PriBoris/MBLv1/Hardware/MBLv1 hardware utils.xlsx

Sheet: Sheet1
I nom | 0.35 | A
Intensity | 100 | %
I | 0.35 | A
R shunt | 0.100 | Ohm
U shunt | 0.035 | V
P shunt | 0.01225 | W
U offset | 0.006 | V
Amplifier
R1 | 220 | kOhm
R2 | 4.7 | kOhm
Gain | 47.80851064
U | 1.960148936

Sheet: BATTERY CHARGE
R shunt | 0.01 | ohm
I charge @5V | 1.5 | A
U | 4 | V
I charge | 1.875 | A
U shunt | 0.01875
P shunt | 0.03515625 | W
R load INA138 | 470000 | ohm
U load INA138 | 1.7625 | V

Sheet: USB VOLTAGE MONITORING
 |  |  | V USB
V REF INT | 1.224 | V | 3.918024
3/4 V REF INT | 0.918 | V | 2.938518
1/2 V REF INT | 0.612 | V | 1.959012
1/4 V REF INT | 0.306 | V | 0.979506
V USB MIN | 4.5 | V
Rup | 220 | kOhm
Rdown1 | 100 | kOhm
Rdown2 | 220000
Rdown | 99.95456611 | kOhm
G | 0.3124023743
V COMP IN | 1.405810684

Sheet: THERMAL
COPPER | 401 | W/m/K
TRACK
width | 1 | mm | 0.001 | m
length | 1 | mm | 0.001 | m
copper thickness | 0.1 | mm | 0.0001 | m
Area | 0.1 | mm^2 | 1e-07 | m^2
Theta |  |  | 24.938 | K/W
VIA
inner diameter | 0.5 | mm | 0.0005 | m
outer diameter | 0.6 | mm | 0.0006 | m
area | 0.082500 | mm^2 | 8.25e-08 | m^2
pcb thickness | 1.5 | mm | 0.0015 | m
Theta |  |  | 45.34119247 | K/W

Sheet: BATTERY OUT
string current | 0.35 | A
string voltage | 6.6 | V
string power | 2.31 | W
string count | 4
total LED power | 9.24
battery voltage | 3.5 | V
battery LED current | 2.64 | A
battery switch R | 0.01 | 0.05 | 0.1 | Ohm
battery switch P | 0.069696 | 0.34848 | 0.69696 | W
battery switch U | 0.0264 | 0.0264 | 0.0264 | V
