PriBoris/MBLv1/Hardware/BOM/MBLv1(both).xlsx

Comment | Quantity | Описание
CC1206KKX7R6BB226 | 9 | Конденсатор SMD 1206
CC0603KRX7R7BB224 | 4 | Конденсатор SMD 0603
CC0603KRX7R7BB104 | 12 | Конденсатор SMD 0603
LMV324IDR | 1 | Микросхема SO14
TPS71533DCKR | 1 | Микросхема SOT323-5
TPS28225D | 1 | Микросхема SO8
STM32L052C8T | 1 | Микросхема LQFP48
IHLP4040DZER101M | 5 | Индуктивность SMD 2525
CRA2512-FZ-R100ELF | 4 | Резистор SMD 2512
RC0603FR-074K7 | 7 | Резистор SMD 0603
RC0603FR-07100R | 2 | Резистор SMD 0603
RC0603FR-07220K | 8 | Резистор SMD 0603
RC0603FR-07470K | 5 | Резистор SMD 0603
RC0603FR-07100K | 6 | Резистор SMD 0603
CRA2512-FZ-R010ELF | 1 | Резистор SMD 2512
RC0603FR-0747K | 4 | Резистор SMD 0603
RC0603FR-075R1 | 4 | Резистор SMD 0603
TC-3121 | 3 | Кнопка
INA138NA | 1 | Микросхема SOT23-5
L-119EGWT | 1 | Светодиод красный/зеленый
10BQ040 | 4 | Диод SMB
30BQ040 | 1 | Диод SMC
BAT54 | 6 | Диод SOT23
IRLL2705 | 6 | Транзистор SOT223
IRF7410 | 1 | Транзистор SO8
IRLML6402 | 4 | Транзистор SOT23
IRLML2402 | 4 | Транзистор SOT23
PDTA143ET | 2 | Транзистор SOT23
MOLEX 47346-0001 | 1 | Разъем USB micro
LM75A | 2 | Микросхема SO8
RC1206JR-070R | 16 | Резистор SMD 1206
OLP-5065F6L-06A | 8 | Светодиод SMD
