PriBoris/MBLv1/Hardware/BOM/MBLv1(LEDBoard).xlsx

Comment | Quantity | Описание
CC0603KRX7R7BB104 | 1 | Конденсатор SMD 0603
LM75A | 1 | Микросхема SO8
RC1206JR-070R | 8 | Резистор SMD 1206
OLP-5065F6L-06A | 4 | Светодиод SMD
