PriBoris/MBLv1/Hardware/MBLv1(LEDBoard).step

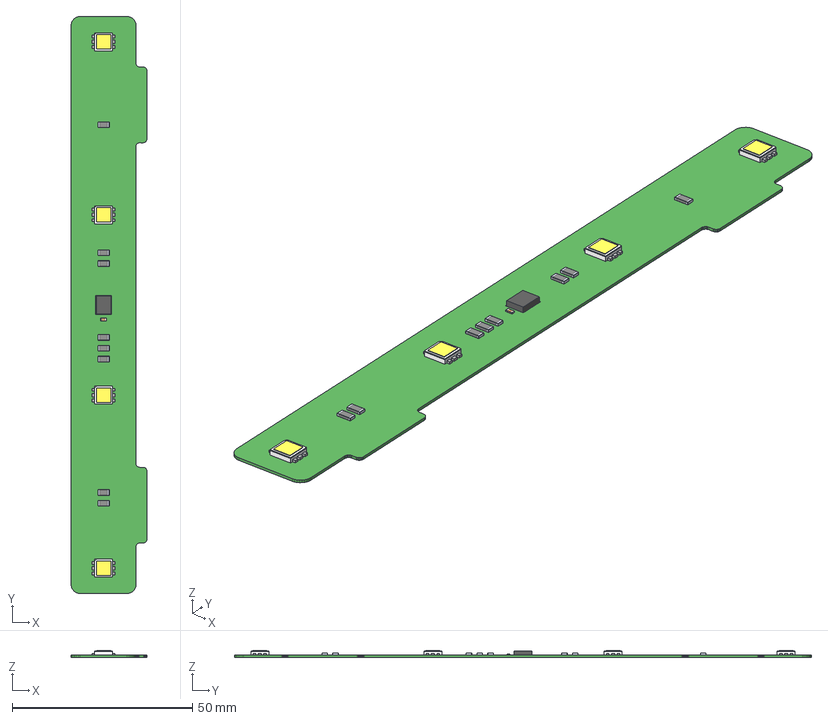
[picture p1: CAD file, 2017-07-03]
Hardware/MBLv1(LEDBoard).step
21.0 x 160.0 x 1.95 mm
Board
User_Library-Chip_Resistor2RESC3216X60N x 8
Extruded x 37
SW3dPS-0603_SMD_Capacitor
