PriBoris/MBLv1/Hardware/MBLv1.step

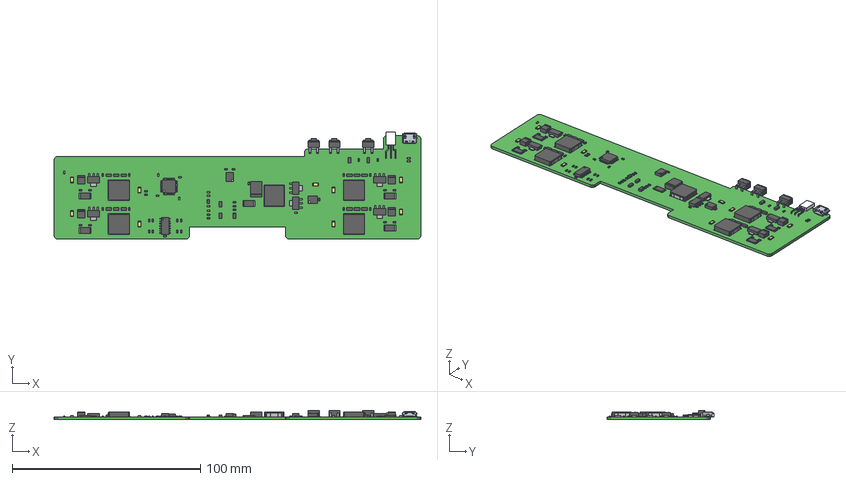
[picture p2: CAD file, 2017-06-19]
Hardware/MBLv1.step
195.0 x 57.0 x 5.03 mm
Board
Extruded x 380
