PriBoris/MBLv1/Hardware/MBLv1(LEDBoard).PDF

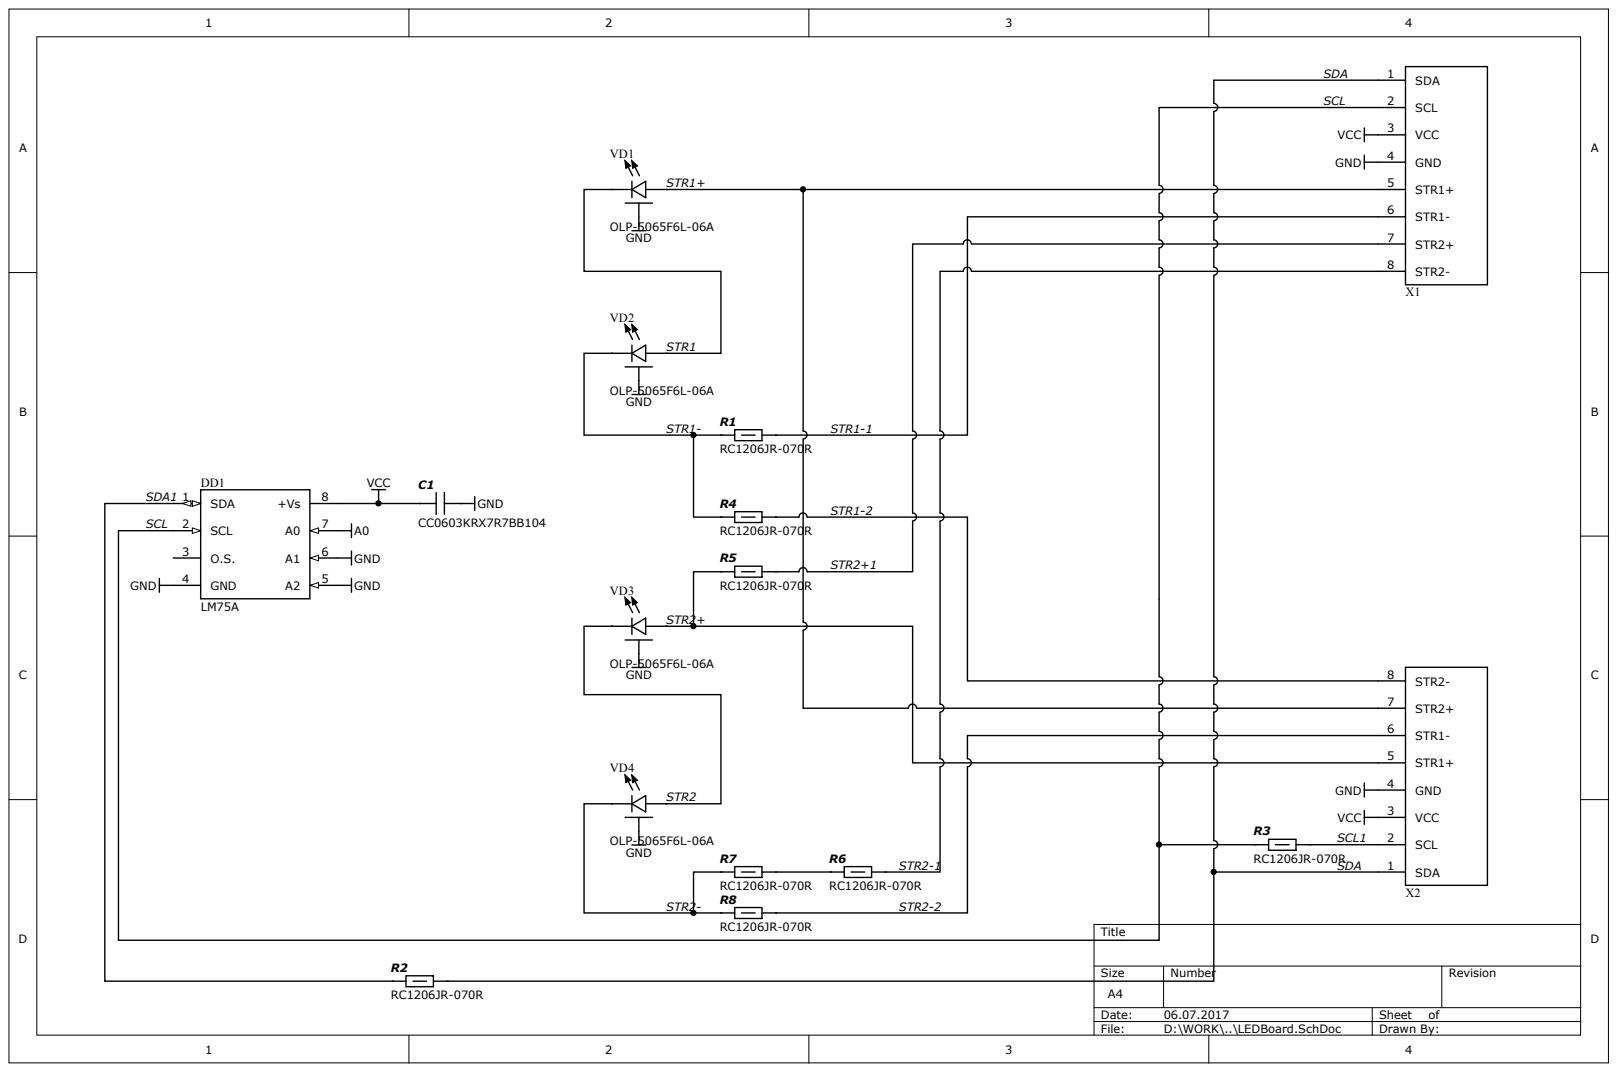
[picture p3: page 1]

SCL | 2

SCL 2

3 | SC L A0 A1 O.S. A2 | 5 GND | RC 1 2 0 6JR-0 7 0 R 5 | R STR2+1

OLP-5 | | F 6L-0 6 A

OLP-5
GND | R 7 | R 6 | STR2-1 | RC 1 2 0 6JR-0 7 0 R SDA 1

- | RC 6JR-0 R 8 | 7 0 R RC 6JR-0 7 0 R STR2-2

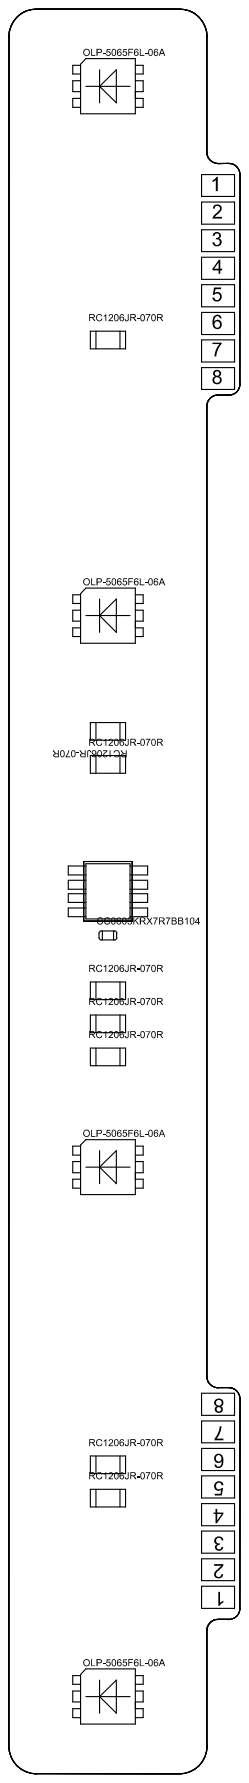
[picture p4: page 2]

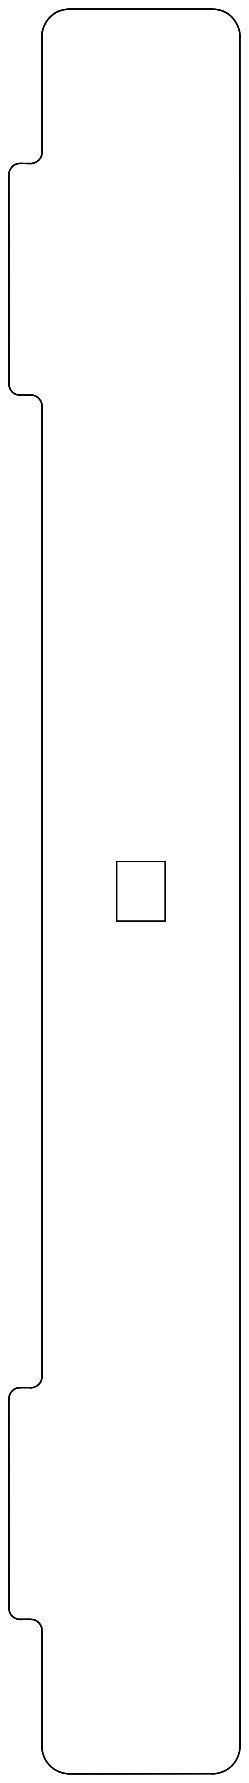
[picture p5: page 3]

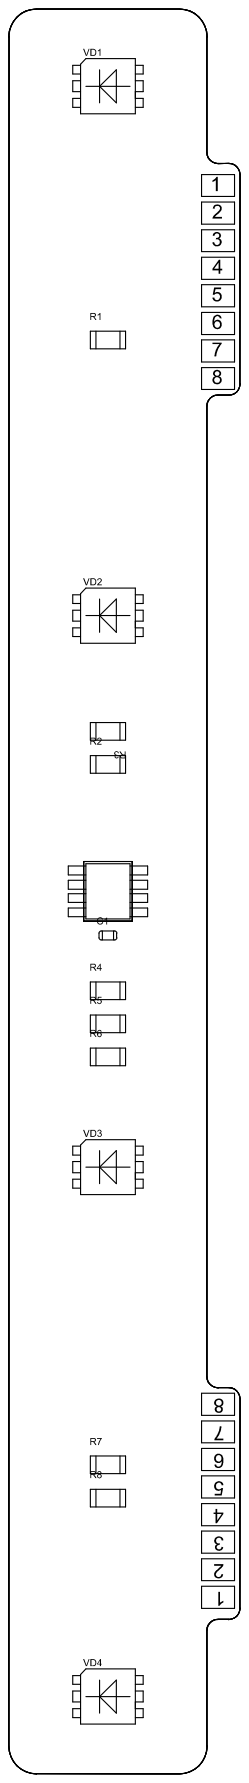
[picture p6: page 4]

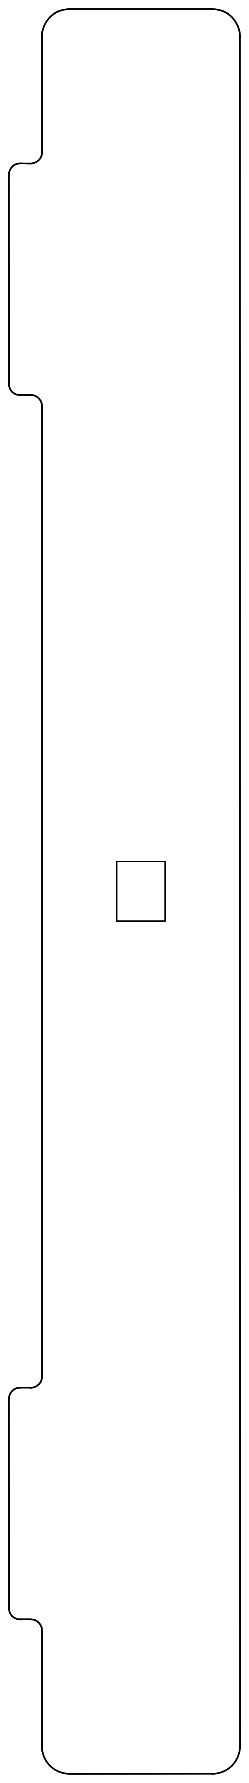
[picture p7: page 5]

Comment | Designator | Quantity | Описание

CC0603KRX7R7BB104 | C1 | 1 | Конденсатор SMD 0603
LM75A | DD1 | 1 | Микросхема SO8
RC1206JR-070R | R1, R2, R3, R4, R5, R6, R7, R8 | 8 | Резистор SMD 1206

OLP-5065F6L-06A | VD1, VD2, VD3, VD4 | 4 | Светодиод SMD

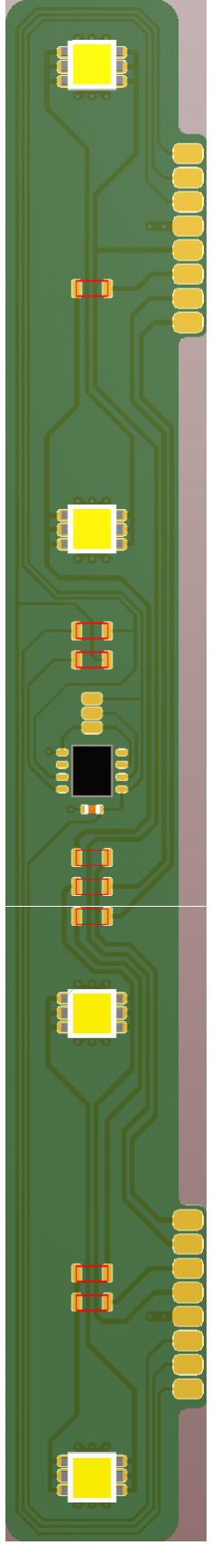
[picture p8: figure]

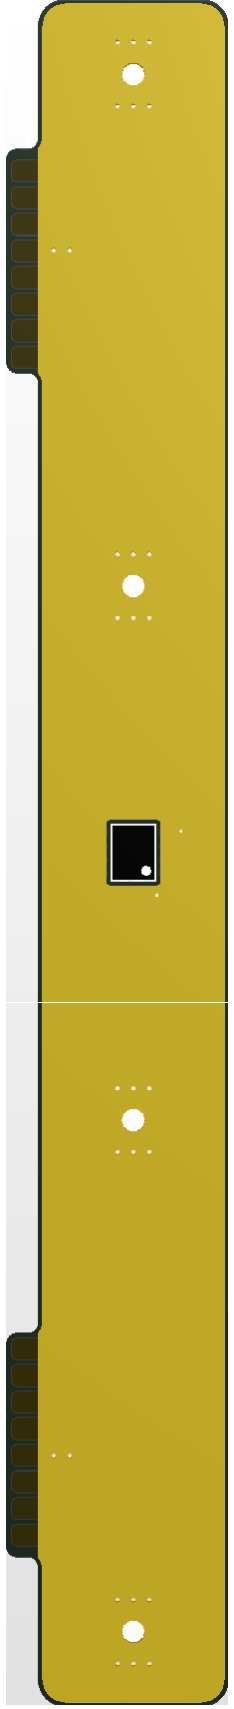
[picture p9: figure]
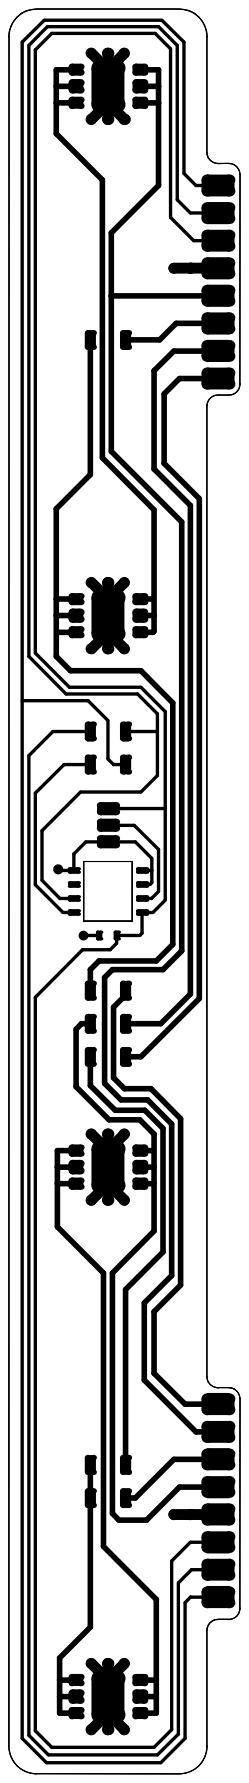
[picture p10: page 9]

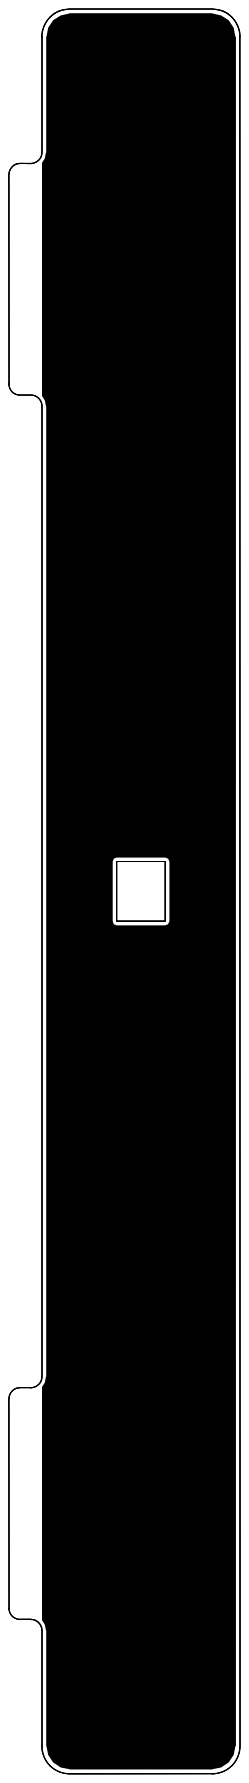
[picture p11: page 10]
