PriBoris/MBLv1/Hardware/Simulation/charger1.CIR

[Main]
FileType=CIR
Version=9.00
Program=Micro-Cap
Screen=1920,1080
MCAPVersion=9.0.7.0
Key ID=2 233 293 684
NLCnt=66
TXCnt=6

[shapedef]
Name=Battery
Line=0,0,22,0
Line=22,-3,22,3
Line=26,-7,26,7
Line=26,0,48,0
Current=32,8,16,8

[shapedef]
Name=SPICE_V
Root="Vsource.root",0,-12,0

[shapedef]
Name=Resistor
PolyOpen=12 
PolyLine=0,0
PolyLine=0,0
PolyLine=12,0
PolyLine=14,-4
PolyLine=18,4
PolyLine=22,-4
PolyLine=26,4
PolyLine=30,-4
PolyLine=34,4
PolyLine=36,0
PolyLine=48,0
PolyLine=48,0
Current=32,8,16,8

[shapedef]
Name=Capacitor
Line=0,0,22,0
Line=22,-8,22,8
Line=26,-8,26,8
Line=26,0,48,0
Current=32,12,16,12

[shapedef]
Name=Inductor
Line=42,0,48,0
Line=0,0,5,0
Arc=5,-7,17,7 , 11,-7,5,0
Arc=13,-7,25,7 , 19,-7,13,0
Arc=29,-7,41,7 , 35,-7,29,0
Arc=21,-7,33,7 , 27,-7,21,0
Arc=6,-7,18,7 , 18,0,12,-7
Arc=14,-7,26,7 , 26,0,20,-7
Arc=22,-7,34,7 , 34,0,28,-7
Arc=30,-7,42,7 , 42,0,36,-7
Line=11,-7,12,-7
Line=19,-7,20,-7
Line=27,-7,28,-7
Line=35,-7,36,-7
Arc=13,-4,17,2 , 13,-1,15,2
Arc=29,-4,33,2 , 29,-1,31,2
Arc=21,-4,25,2 , 21,-1,23,2
Arc=14,-4,18,2 , 16,2,18,-1
Arc=30,-4,34,2 , 32,2,34,-1
Arc=22,-4,26,2 , 24,2,26,-1
Line=15,2,16,2
Line=23,2,24,2
Line=31,2,32,2
Line=5,5,9,5
Line=41,5,41,9
Line=39,7,43,7
Current=32,8,16,8

[shapedef]
Name=Schottky
Arc=18,-13,31,1 , 27,-13,18,-7
Root="Diode.root",0,-8,0
Arc=19,-13,30,0 , 27,-13,19,-7
Arc=8,0,20,13 , 12,13,20,7
Arc=9,0,19,13 , 12,13,19,7

[shapedef]
Name=DNMOS
Root="Mos2.root",0,-24,0
Line=14,0,24,0
PolyClosed=3 ,Solid
PolyLine=17,0
PolyLine=20,-3
PolyLine=20,3

[shapedef]
Name=DPMOS
Root="Mos2.root",0,-24,0
Line=14,0,24,0
PolyClosed=3 ,Solid
PolyLine=17,-3
PolyLine=17,3
PolyLine=20,0

[shapedef]
Name=Ground
Line=0,0,12,0
Line=12,-8,12,8
Line=18,-4,18,4
Line=24,0,24,0

[shapedef]
Name=Diode.root
Line=0,0,20,0
Line=28,0,48,0
Rectangle=18,-8,20,8,SOLID
PolyClosed=3 ,Solid
PolyLine=20,0
PolyLine=28,-8
PolyLine=28,8
Current=32,16,16,16

[shapedef]
Name=Vsource.root
Line=0,0,12,0
Line=36,0,48,0
Ellipse=12,-12,36,12
Line=7,5,7,9
Root="Plus.root",39,5,0
Current=32,16,16,16

[shapedef]
Name=Plus.root
Line=-2,0,2,0
Line=0,-2,0,2

[shapedef]
Name=Mos2.root
Line=0,8,10,8
Line=10,-8,10,8
Line=14,-11,14,-5
Line=14,-3,14,3
Line=14,5,14,11
Line=14,-8,24,-8
Line=14,8,24,8
Line=24,0,24,24
Line=24,-8,24,-24
Current=32,-24,32,-16
Current=32,24,32,16
Current=0,0,8,0

[compdef]
Name=IRLL2705_IR
Definition=Subckt
Shape=DNMOS
Mask=4224
memo=N-Channel HEXFET Power MOSFET 55V 3.8A
Label Offset=30,-13,-6,26
PinCnt=3
Pin="1",a,3,-3,5,5
Pin="2",a,0,1,-3,-3
Pin="3",a,3,3,6,6

[compdef]
Name=IRLML6401
Definition=Subckt
Shape=DPMOS
Mask=5248
memo=P-Channel Power MOSFET Vdss=-12V Id=-4.3A Rds=50mohm
Label Offset=30,-9,-5,27
PinCnt=3
Pin="2",a,0,1,-6,-3
Pin="1",a,3,-3,6,6
Pin="3",a,3,3,6,6

[compdef]
Name=IRLML2402_IR
Definition=Subckt
Shape=DNMOS
Mask=4224
memo=N-Channel HEXFET Power MOSFET 20V 1.2A
Label Offset=30,-13,-6,26
PinCnt=3
Pin="1",a,3,-3,5,5
Pin="2",a,0,1,-3,-3
Pin="3",a,3,3,6,6

[compdef]
Name=Ground
Definition=Ground
Shape=Ground
Mask=1793
memo=Ground
Label Offset=0,0,0,0
PinCnt=1
Pin="PinA",0,0,-3,-7

[compdef]
Name=Battery
Definition=Battery
Shape=Battery
Mask=4865
memo=Battery
Label Offset=19,7,10,13
PinCnt=2
Pin="Plus",6,0,-4,-5
Pin="Minus",0,0,-10,-5

[compdef]
Name=Voltage Source
Definition=VSpice
Shape=SPICE_V
Mask=4864
memo=Voltage Source
Label Offset=19,13,15,13
PinCnt=2
Pin="Plus",6,0,-5,-6
Pin="Minus",0,0,-20,-6

[compdef]
Name=Inductor
Definition=Inductor
Shape=Inductor
Mask=7681
memo=Inductor
Label Offset=18,9,11,12
PinCnt=2
Pin="Plus",6,0,-5,-9
Pin="Minus",0,0,-3,-9

[compdef]
Name=Capacitor
Definition=Capacitor
Shape=Capacitor
Mask=7425
memo=Capacitor
Label Offset=16,12,12,12
PinCnt=2
Pin="Plus",6,0,-3,-5
Pin="Minus",0,0,-14,-5

[compdef]
Name=Resistor
Definition=Resistor
Shape=Resistor
Mask=6401
memo=Resistor
Label Offset=18,6,8,11
PinCnt=2
Pin="Plus",6,0,-10,-4
Pin="Minus",0,0,-14,-4

[compdef]
Name=10BQ040_IR
Definition=Diode
Shape=Schottky
Mask=4480
memo=Schottky Rectifier Vr=40V If=1A
Label Offset=19,10,12,12
PinCnt=2
Pin="Anode",6,0,-12,-3
Pin="Cathode",0,0,-24,-3

[Circuit]
Window Placement=2,3, -1,-1, -4,-23, 0,0,1212,664
Default Object=Color=#000080
Default Object Font=Height=-15,FStyle=0,Color=#000080,Name=Arial
Default Object Apply Border To Text=No
Default Object Apply Fill To Text=No
WinBackGround Color=#FFFFFF
Select Color=#FF0000
Select Box Color=#000080
Grid Text Color=Height=-12,FStyle=0,Color=#0000FF,Name=Verdana
Component Color=#0000FF
Attribute Text=Height=-12,FStyle=0,Color=#008000,Name=Verdana
Wire Color=#008000
Bus Color=#008000
Pin Connection=Height=-10,FStyle=0,Color=#FF0000,Name=Arial
Node Number=Height=-11,FStyle=0,Color=#FF00FF,Name=Arial
Node Voltage Color=#000000
Dynamic AC Voltage Color=#E4E4E4
Text Banner Text=Height=-15,FStyle=0,Color=#800000,Name=Arial
Title Block Background=#C0C0C0
Current=Height=-11,FStyle=0,Color=#0000FF,Name=Arial
Power/Condition=Height=-11,FStyle=0,Color=#FF0000,Name=Arial
Digital Path Color=#FF0000
Title Block=Height=-15,FStyle=0,Color=#000000,Name=Arial
Disabled	Color=#C0C0C0
KeyWord Color=#0000FF
Error	Color=#FF0000
Digital 0 Color=#000000
Digital R Color=#FFFF00
Digital F Color=#FFFF00
Digital 1 Color=#FF0000
Digital X Color=#C0C0C0
Digital Z Color=#808080
Window Placement in Transient Analysis=2,3, -1,-1, -4,-23, 22,22,1474,671
SpiceType=AMBIGUOUS
Block Select Color=#51F998
TitleBlock Field_1=$name
TitleBlock Field_2=$user $company
TitleBlock Field_3
TitleBlock Field_4=$date
TitleBlock Field_5=Page $page of $maxpage
TitleBlock One Title=False
Title_Block_Border=False
Title_Block=False
Show Nodes=False
Show Voltages=False
Show Current=False
Show Power=False
Show Condition=False
Show Pin Connections=False
Show Cross=False
Show Attribute Text=True
Show Grid Text=True

[Comp]
Name=IRLL2705_IR
Grid=68,38

[Attr]
ONV=30,-13,PART,X1
Style=8192

[Attr]
ONV=30,1,NAME,IRLL2705_IR

[Attr]
ONV=30,29,PACKAGE,SOT-223

[Comp]
Name=IRLML6401
Grid=42,43
Rot=4

[Attr]
ONV=30,-5,PART,X3
Style=8192

[Attr]
ONV=30,-19,NAME,IRLML6401

[Attr]
ONV=30,-47,PACKAGE,MICRO3

[Comp]
Name=IRLML2402_IR
Grid=42,54

[Attr]
ONV=30,-13,PART,X4
Style=8192

[Attr]
ONV=30,1,NAME,IRLML2402_IR

[Attr]
ONV=30,29,PACKAGE,SOT-23

[Comp]
Name=Ground
Grid=27,32
Rot=7

[Comp]
Name=Battery
Grid=27,32
Rot=3

[Attr]
ONV=-26,-27,PART,V1
Style=8192

[Attr]
ONV=-30,-41,VALUE,3.3
Style=8192

[Attr]
ONV=0,0,PACKAGE,

[Comp]
Name=Voltage Source
Grid=13,64
Rot=3

[Attr]
ONV=-31,-27,PART,V2
Style=8192

[Attr]
ONV=-80,-41,VALUE,DC 0 AC 1 0 Pulse 0 3.3 1u 100n 100n 3u 10u

[Attr]
ONV=0,0,PACKAGE,

[Attr]
ONV=0,0,Saved_Pulse,DC 0 AC 1 0 Pulse 0 3.3 1u 100n 100n 3u 10u
Style=256

[Comp]
Name=Ground
Grid=13,64
Rot=7

[Wire]
Grids=13,55,42,55

[Wire]
Grids=13,55,13,58

[Wire]
Grids=13,42,42,42

[Wire]
Grids=13,42,13,55

[Wire]
Grids=45,46,45,48

[Comp]
Name=Inductor
Grid=98,59
Rot=6

[Attr]
ONV=-33,9,PART,L1
Style=8192

[Attr]
ONV=-80,23,INDUCTANCE,100u,ic=0
Style=8192

[Attr]
ONV=0,0,PACKAGE,

[Comp]
Name=Capacitor
Grid=108,71
Rot=5

[Attr]
ONV=12,-26,PART,C1
Style=8192

[Attr]
ONV=12,-40,CAPACITANCE,47u,ic=0
Style=8192

[Attr]
ONV=0,0,PACKAGE,

[Comp]
Name=Ground
Grid=108,71
Rot=7

[Wire]
Grids=98,59,108,59

[Wire]
Grids=108,59,108,65

[Comp]
Name=Resistor
Grid=118,65
Rot=1

[Attr]
ONV=8,11,PART,R1
Style=8192

[Attr]
ONV=8,25,RESISTANCE,10000
Style=8192

[Attr]
ONV=0,0,PACKAGE,

[Comp]
Name=Ground
Grid=118,71
Rot=7

[Wire]
Grids=108,59,118,59

[Wire]
Grids=118,59,118,65

[Comp]
Name=Ground
Grid=82,32
Rot=7

[Comp]
Name=Battery
Grid=82,32
Rot=3

[Attr]
ONV=-26,-27,PART,V3
Style=8192

[Attr]
ONV=-30,-41,VALUE,5.0
Style=8192

[Attr]
ONV=0,0,PACKAGE,

[Wire]
Grids=71,26,71,35

[Wire]
Grids=71,41,71,59

[Wire]
Grids=71,59,92,59

[Comp]
Name=10BQ040_IR
Grid=71,65
Rot=7

[Attr]
ONV=-29,12,PART,D1
Style=8192

[Attr]
ONV=-91,26,MODEL,10BQ040_IR

[Attr]
ONV=-76,54,PACKAGE,DO-214AA

[Comp]
Name=Ground
Grid=71,71
Rot=7

[Wire]
Grids=71,59,71,65

[Comp]
Name=Capacitor
Grid=59,56
Rot=5

[Attr]
ONV=12,-26,PART,C2
Style=8192

[Attr]
ONV=13,-40,CAPACITANCE,22u,ic=3.3
Style=8192

[Attr]
ONV=0,0,PACKAGE,

[Wire]
Grids=71,26,82,26

[Wire]
Grids=59,56,59,59

[Wire]
Grids=59,59,71,59

[Comp]
Name=10BQ040_IR
Grid=59,26
Rot=1

[Attr]
ONV=12,12,PART,D2
Style=8192

[Attr]
ONV=12,26,MODEL,10BQ040_IR

[Attr]
ONV=12,54,PACKAGE,DO-214AA

[Wire]
Grids=59,32,59,35

[Wire]
Grids=45,35,45,40

[Wire]
Grids=45,35,56,35

[Wire]
Grids=59,35,59,50

[Wire]
Grids=27,26,34,26

[Wire]
Grids=53,39,68,39

[Wire]
Grids=53,39,53,48

[Wire]
Grids=45,48,53,48

[Wire]
Grids=45,48,45,51

[Wire]
Grids=56,35,59,35

[Comp]
Name=Voltage Source
Grid=13,102
Rot=3

[Attr]
ONV=-31,-27,PART,V4
Style=8192

[Attr]
ONV=-80,-41,VALUE,DC 0 AC 1 0 Pulse 0 3.3 5u 100n 100n 4u 10u

[Attr]
ONV=0,0,PACKAGE,

[Attr]
ONV=0,0,Saved_Pulse,DC 0 AC 1 0 Pulse 0 3.3 5u 100n 100n 4u 10u
Style=256

[Comp]
Name=Ground
Grid=13,102
Rot=7

[Wire]
Grids=13,81,13,83

[Comp]
Name=IRLML6401
Grid=42,84
Rot=4

[Attr]
ONV=30,-5,PART,X5
Style=8192

[Attr]
ONV=30,-19,NAME,IRLML6401

[Attr]
ONV=30,-47,PACKAGE,MICRO3

[Comp]
Name=IRLML2402_IR
Grid=42,95

[Attr]
ONV=30,-13,PART,X6
Style=8192

[Attr]
ONV=30,1,NAME,IRLML2402_IR

[Attr]
ONV=30,29,PACKAGE,SOT-23

[Wire]
Grids=13,96,42,96

[Wire]
Grids=13,83,42,83

[Wire]
Grids=45,87,45,89

[Comp]
Name=Ground
Grid=45,98
Rot=7

[Wire]
Grids=45,76,45,81

[Wire]
Grids=45,89,52,89

[Wire]
Grids=45,89,45,92

[Wire]
Grids=13,83,13,96

[Wire]
Grids=34,76,45,76

[Wire]
Grids=34,26,34,76

[Wire]
Grids=34,26,59,26

[Comp]
Name=IRLL2705_IR
Grid=56,88

[Attr]
ONV=30,-13,PART,X7
Style=8192

[Attr]
ONV=30,1,NAME,IRLL2705_IR

[Attr]
ONV=30,29,PACKAGE,SOT-223

[Wire]
Grids=59,59,59,85

[Comp]
Name=Ground
Grid=59,91
Rot=7

[Wire]
Grids=45,57,45,59

[Wire]
Grids=45,59,59,59

[Wire]
Grids=52,89,56,89

[Grid Text]
Text="A1"
Grid=13,42
CBorder=NONE

[Grid Text]
Text="A2"
Grid=59,59
CBorder=NONE

[Grid Text]
Text="A3"
Grid=56,35
CBorder=NONE

[Grid Text]
Text="A4"
Grid=118,59
CBorder=NONE

[Grid Text]
Text="AA1"
Grid=13,81
CBorder=NONE

[Grid Text]
Text="AA5"
Grid=52,89
CBorder=NONE

[Schematic]
CurrentSection 0=0
CurrentSection 1=0
CurrentSection 2=0
CurrentSection 3=0
Splitter.xs=0
Splitter.ys=0
TextQuad=4099
Scale=1
PrinterScale=1
GridType=Normal
GridUser=10
ShapeGroups="Main","Euro","DeMorgan","Polarity","Electrolytic"
CalcRMS=False
CalcAVG=False
CalcPeak=False
DisplayMeasure=Last

[Tools]
Pos=Top
PROBE=Yes
SELECT=Yes
COMP=Yes
TEXT=Yes
WIRE=Yes
WIRED=Yes
BUS=Yes
GRAPHIC=Yes
LINE=No
ELLIPSE=No
RECT=No
DIAM=No
ARC=No
PIE=No
LEFTBRK=No
RIGHTBRK=No
BOTHBRK=No
FLAG=Yes
META=No
INFO=Yes
HELP=Yes
LINK=Yes
REGION_ENABLE=Yes
DIGTRC=No
DIGTRC2=No
DIGALL=No
GRIDTEXT=Yes
COMPTEXT=Yes
NODE=Yes
MEASURED=Yes
NODEV=Yes
CURRENT=Yes
POWER=Yes
CONDITIN=Yes
PIN=Yes
CROSS=No
GRID=Yes
BORDER=No
TITLE=Yes
RUBBER=Yes
PROPERTY=Yes
STEP=Yes
MIRROR=Yes
ROTATE=Yes
FLIPY=Yes
FLIPX=Yes
FINDCOMP=Yes
FIND=Yes
REPEAT=No
MODEL=Yes
CIR2CKT=No
ATTDISP=No
ENABLE=Yes
DISABLE=Yes
TOFRONT=Yes
TOBACK=Yes
SELNEXT=No
PAGEADD=No
PAGEDEL=No
ZOOMIN=Yes
ZOOMOUT=Yes
GOTOFLAG=No
UPLEVEL=Yes
COLOR=Yes
FONT=Yes

[Section]
Index=0
Name="charger1"
Type=Main
Enable=True
CurrentPage 0=0
CurrentPage 1=0
CurrentPage 2=0
CurrentPage 3=0
TabSize 0=400
TabSize 1=400
TabSize 2=400
TabSize 3=400

[Page]
Index=0
Section=0
Print=True
Enable=True
Name=Main
Scale 0=1
Scale 1=1
Scale 2=1
SB 3=0,144
Scale 3=1
Grid=120,69

[Page]
Index=1
Section=0
Type=Text
Print=False
Enable=True
Name=Text

[Page]
Index=2
Section=0
Type=Text
Print=False
Enable=True
Name=Models

[Page]
Index=3
Section=0
Type=Info
Print=False
Enable=True
Name=Info

[Text Area]
Section=0
Page=1
Font=Height=-15,FStyle=0,Color=#000000,Name=Courier New
Comment Color=#008000
Background Color=#FFFFFF
Len=0


[Text Area]
Section=0
Page=2
Font=Height=-15,FStyle=0,Color=#000000,Name=Courier New
Comment Color=#008000
Background Color=#FFFFFF
Len=0


[Transient]
Window Placement=2,3, -1,-1, -4,-23, 22,22,1474,671
Font=Height=-15,FStyle=0,Color=#0000FF,Name=Arial
WinBackGround Color=#FFFFFF
Select Color=#FF0000
Select Box Color=#000080
Title
AutoTitle=Yes
Grid Color=#808080
Grid Weight=1
Grid Pattern=Dot6
Tracker Foreground=Height=-15,FStyle=0,Color=#000000,Name=Arial
Tracker Background=#FFFF00
Baseline color=#0000FF
Static Grids=False
PlusMark=False
MinorLog25=Off
LabelMinor=Off
OperPoint=True
OperPointOnly=False
AutoScaleRanges=True
DataPoints=False
Token=False
Ruler=False
XAxisGrids=True
YAxisGrids=True
MinorLogGrids=True
BaseLine=False
Graph Background=#FFFFFF
Tracker Intercept=False
Tracker Mouse=True
Tracker Cursor=True
Tracker Cursor BranchInfo=False
Horizontal Cursor=False
Same Y Scales=Yes
Enable X Scaling=True
Enable Y Scaling=True
Keep X Scales The Same=False
Number of Grids X=5
Number of Grids Y=5
Cursor Select Color Primary=#C0C0C0
Cursor Select Color Secondary=#FF0000
Data Point Labels Color Fore=Height=-15,FStyle=0,Color=#000000,Name=Arial
Data Point Labels Color Back=#FFFF00
FFT_NPts="1024"
FFT_IncludeDCHarmonic=False
FFT_AutoScale_Harmonics="10"
PrinterAutoTile=No
PrinterBlackBorder=No
MonMaxShow=9
MonPageWidth=66
MonPlotWidth=21
MonExprXWidth=142
MonExprYWidth=260
MonRangeXWidth=90
MonRangeYWidth=90
AnimateWait=0
AnimateWaitTime=500
Save_For_Future=No
Reduce_Display=1
Reduce_Save=1
Num Out Header Left
Num Out Header Center="$MC\n$user\n$company\n$Analysis of $name"
Num Out Header Right
Num Out Delimiter=32
Num Out Write=True
Num Out Write Main Header=True
Num Out Write Limits=True
Num Out Write Branch Header=True
Num Out Write Models=True
Num Out Write Zero Models=True
Num Out Write Undefined Models=True
Num Out Write Operating Point=True
Num Out Write Values=True
Num Out Write Waveform Header=True
Num Out Low="TMIN"
Num Out High="TMAX"
Num Out Font=Height=-15,FStyle=0,Color=#000000,Name=Courier New

[Tools]
Pos=Top
SELECT=Yes
GRAPHIC=Yes
LINE=No
ELLIPSE=No
RECT=No
DIAM=No
ARC=No
PIE=No
LEFTBRK=No
RIGHTBRK=No
BOTHBRK=No
POLYCLOS=No
SCALE=Yes
CURSOR=Yes
MEASUREH=Yes
MEASUREV=Yes
TAG=Yes
PTAG=Yes
TEXT=Yes
PROPERTY=Yes
START=Yes
STOP=Yes
PAUSE=Yes
DATAPTS=Yes
TOKENS=Yes
RULER=Yes
PLUS=Yes
XAXIS=Yes
YAXIS=Yes
MINORLOG=Yes
LOG25=Yes
BASELINE=Yes
HORIZCUR=Yes
GOTOX=Yes
GOTOY=Yes
GOTOPERF=Yes
GOTOBRNC=Yes
CLEAR_ACCUMULATED=Yes
PDELETE_ALL_PLOTS=Yes
NEXT=Yes
NEXTIN=Yes
PEAK=Yes
VALLEY=Yes
HIGH=Yes
LOW=Yes
INFLECTN=Yes
GHIGH=Yes
GLOW=Yes
BOTTOM=Yes
TOP=Yes
WAVEFORMBUFFER=Yes
AOUTPUT=Yes
PKEY=Yes
ENXSCALE=Yes
ENYSCALE=Yes
ZOOMIN=Yes
ZOOMOUT=Yes
AUTOSCALE=Yes
COLOR=Yes
FONT=Yes
SELNEXT=No

[APage]
Analysis=Transient
Name="Main"

[Monte Carlo Options]
Analysis=Transient
Status=Off
Zero Tolerance=False
Distribution=Normal
Number of Runs=10
Seed=0

[Limits]
Analysis=Transient
TRange=1m
TStep=0
NPts=51
Temp=27
RetraceRuns=1
StateVar=Zero
RunOption=Normal
Temperature Type=Linear
Accumulate Plots=False

[WaveForm]
Analysis=Transient
Plt=1
AliasID=1
XExp=T
YExp=v(A1)
XRng=0.001
YRng=5
Options=LINEARX,LINEARY
Range Grid X=0.0002
Range Grid Y=1
Line Color=#0000FF
Text Color=#0000FF
Rainbow=False
VFmtX=3
VFmtY=3
ScaleFactorX="None"
ScaleFactorY="None"
ScaleUnitsX="Auto"
ScaleUnitsY="Auto"
SFmtX=3
SFmtY=3

[WaveForm]
Analysis=Transient
Plt=1
AliasID=5
XExp=T
YExp=v(AA1)
XRng=0.001
YRng=5
Options=LINEARX,LINEARY
Range Grid X=0.0002
Range Grid Y=1
Line Color=#FF0000
Text Color=#FF0000
Rainbow=False
VFmtX=3
VFmtY=3
ScaleFactorX="None"
ScaleFactorY="None"
ScaleUnitsX="Auto"
ScaleUnitsY="Auto"
SFmtX=3
SFmtY=3

[WaveForm]
Analysis=Transient
Plt=1
AliasID=2
XExp=T
YExp=0
XRng=0.001
YRng=1,-1
Options=LINEARX,LINEARY
Range Grid X=0.0002
Range Grid Y=1
Line Color=#FF0000
Text Color=#FF0000
Rainbow=False
VFmtX=3
VFmtY=3
ScaleFactorX="None"
ScaleFactorY="None"
ScaleUnitsX="Auto"
ScaleUnitsY="Auto"
SFmtX=3
SFmtY=3

[WaveForm]
Analysis=Transient
Plt=2
AliasID=3
XExp=T
YExp=v(A3)-v(A2)
XRng=0.001
YRng=4,1.5
Options=LINEARX,LINEARY
Range Grid X=0.0002
Range Grid Y=0.5
Line Color=#008000
Text Color=#008000
Rainbow=False
VFmtX=3
VFmtY=3
ScaleFactorX="None"
ScaleFactorY="None"
ScaleUnitsX="Auto"
ScaleUnitsY="Auto"
SFmtX=3
SFmtY=3

[WaveForm]
Analysis=Transient
Plt=3
AliasID=4
XExp=T
YExp=v(A2)
XRng=0.001
YRng=2.4,-0.6
Options=LINEARX,LINEARY
Range Grid X=0.0002
Range Grid Y=0.6
Line Color=#FF00FF
Text Color=#FF00FF
Rainbow=False
VFmtX=3
VFmtY=3
ScaleFactorX="None"
ScaleFactorY="None"
ScaleUnitsX="Auto"
ScaleUnitsY="Auto"
SFmtX=3
SFmtY=3

[WaveForm]
Analysis=Transient
Plt=3
AliasID=6
XExp=T
YExp=v(A4)
XRng=0.001
YRng=2.4,-0.6
Options=LINEARX,LINEARY
Range Grid X=0.0002
Range Grid Y=0.6
Line Color=#0000FF
Text Color=#0000FF
Rainbow=False
VFmtX=3
VFmtY=3
ScaleFactorX="None"
ScaleFactorY="None"
ScaleUnitsX="Auto"
ScaleUnitsY="Auto"
SFmtX=3
SFmtY=3

[WaveForm]
Analysis=Transient
Plt=4
AliasID=7
XExp=T
YExp=v(AA5)
XRng=0.001
YRng=4.8,-1.2
Options=LINEARX,LINEARY
Range Grid X=0.0002
Range Grid Y=1.2
Line Color=#FF0000
Text Color=#FF0000
Rainbow=False
VFmtX=3
VFmtY=3
ScaleFactorX="None"
ScaleFactorY="None"
ScaleUnitsX="Auto"
ScaleUnitsY="Auto"
SFmtX=3
SFmtY=3

[WaveForm]
Analysis=Transient
Plt=4
AliasID=8
XExp=T
YExp=v(A2)
XRng=0.001
YRng=4.8,-1.2
Options=LINEARX,LINEARY
Range Grid X=0.0002
Range Grid Y=1.2
Line Color=#008000
Text Color=#008000
Rainbow=False
VFmtX=3
VFmtY=3
ScaleFactorX="None"
ScaleFactorY="None"
ScaleUnitsX="Auto"
ScaleUnitsY="Auto"
SFmtX=3
SFmtY=3

[WaveForm]
Analysis=Transient
AliasID=-1
Options=LINEARX,LINEARY
Line Color=#008000
Text Color=#008000
Rainbow=False
VFmtX=3
VFmtY=3
ScaleFactorX="None"
ScaleFactorY="None"
ScaleUnitsX="Auto"
ScaleUnitsY="Auto"
SFmtX=3
SFmtY=3

[Limits]
Analysis=DynamicAC
FirstValueDisplay=Mag
SecondValueDisplay=PhaseDeg
PlaceText=True

[Limits]
Analysis=DynamicDC
PlaceText=True

[Pane]
Analysis=Transient
CurrentPage 0="Main"

[Pane]
Analysis=AC

[Pane]
Analysis=DC

[Pane]
Analysis=Distortion

[Watch]
Analysis=Transient
Format=3
ExprPercentWidth=80

[OPMethods]
Analysis=Transient
Standard Newton-Raphson=0,0
Source Stepping=0,0
Diagonal Gmin Stepping=0,0
Junction Gmin Stepping=0,0
Pseudo Transient=0,0

[OPMethods]
Analysis=AC
Standard Newton-Raphson=0,0
Source Stepping=0,0
Diagonal Gmin Stepping=0,0
Junction Gmin Stepping=0,0
Pseudo Transient=0,0

[OPMethods]
Analysis=DC
Standard Newton-Raphson=0,0
Source Stepping=0,0
Diagonal Gmin Stepping=0,0
Junction Gmin Stepping=0,0
Pseudo Transient=0,0
