PriBoris/MBLv1/(list of files, drawings)

Other design files:
Hardware/MBLv1(LEDBoard).PrjPcb
Hardware/MBLv1.PrjPcb
Hardware/pcb/LEDBoard.PcbDoc
Hardware/pcb/MBLv1.PcbDoc
Hardware/sch/charger.SchDoc
Hardware/sch/control.SchDoc
Hardware/sch/LEDBoard.SchDoc
Hardware/sch/light.SchDoc
