PriBoris/MBLv1/(commit log)

2016-09-20 component placement done
    [MBLv1 hardware utils.xlsx, MBLv1.PcbDoc, MBLv1.step, charger.SchDoc, control.SchDoc, light.SchDoc]
2016-09-28 убрал отросток
    [MBLv1.PcbDoc, MBLv1.step, control.SchDoc]
2016-10-02 separated the board into 3 subboards
    [LEDBoard.PcbDoc, LEDBoard.SchDoc, MBLv1(LEDBoard).PrjPcb, MBLv1(LEDBoard).step, MBLv1(led).PrjPcb, MBLv1.PcbDoc, MBLv1.step, control.SchDoc]
2016-10-03 some amendments in LEDBoard
    [LEDBoard.PcbDoc, LEDBoard.SchDoc, MBLv1(LEDBoard).step, MBLv1(led).PrjPcb, MBLv1.step]
2016-10-24 LED BOARD: 1)changed sensor side 2)all rules changed to 0.3 3)arcs on board edges
    [LEDBoard.PcbDoc, LEDBoard.SchDoc, MBLv1 hardware utils.xlsx, MBLv1(LEDBoard).PrjPcb, MBLv1(LEDBoard).step]
2016-10-30 changed connector pinout
    [LEDBoard.PcbDoc, LEDBoard.SchDoc, MBLv1.PcbDoc, charger.SchDoc, control.SchDoc, light.SchDoc]
2016-11-17 вырез под батарею
    [MBLv1.PcbDoc, MBLv1.step, charger.SchDoc, control.SchDoc, light.SchDoc]
2016-11-29 для светодиодов добавлены отверстия для ручной пайки брюха
    [LEDBoard.PcbDoc, LEDBoard.SchDoc, MBLv1(LEDBoard).step, MBLv1.PcbDoc]
2017-06-19 Reanimate hardware project
    [LEDBoard.PcbDoc, MBLv1.PrjPcb]
2017-06-19 Bugfix micsro-usb connector
    [MBLv1.PcbDoc]
2017-06-19 Update step files
    [MBLv1.step, charger.SchDoc, control.SchDoc]
2017-07-03 Update and check all the patterns on the PCBs
    [LEDBoard.PcbDoc, MBLv1(LEDBoard).step, MBLv1.PcbDoc]
2017-07-03 Add partnumbers to all passive parts
    [LEDBoard.PcbDoc, LEDBoard.SchDoc, MBLv1(LEDBoard).PrjPcb, MBLv1(LEDBoard).step, MBLv1(LEDBoard).xlsx, MBLv1(MainBoard).xlsx, MBLv1(both).xlsx, MBLv1.PcbDoc]
2017-07-03 Fix some partnumbers
    [MBLv1(MainBoard).xlsx, MBLv1(both).xlsx, control.SchDoc]
2017-07-06 Add variants to the LED-board
    [LEDBoard.PcbDoc, LEDBoard.SchDoc, MBLv1(LEDBoard).PrjPcb]
